philkoh/ClaudeCAD/base_hole_view.png

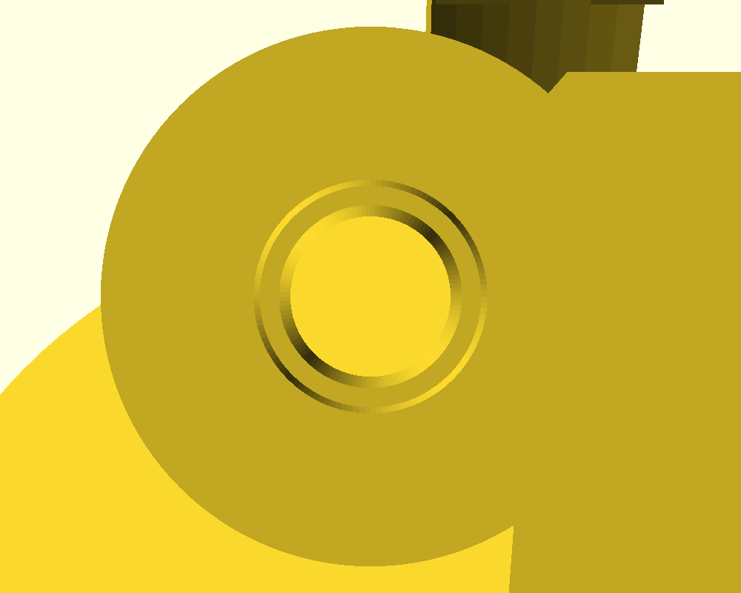
base_hole_view.png
