philkoh/ClaudeCAD/bed_layout.png

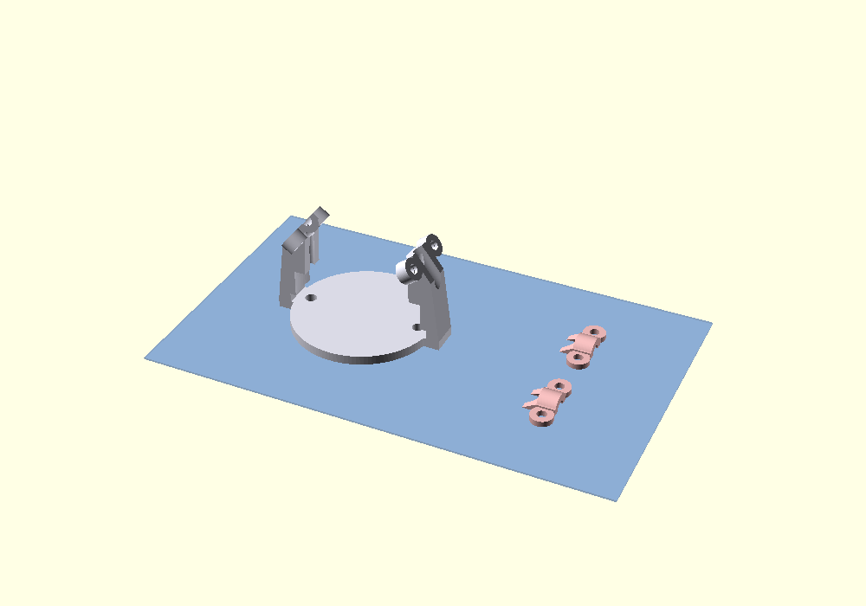
bed_layout.png
