philkoh/ClaudeCAD/bed_preview.png

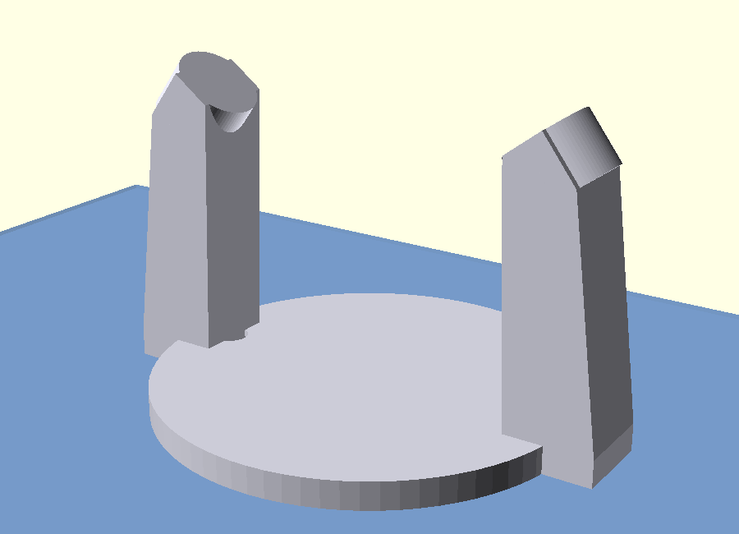
bed_preview.png
