philkoh/ClaudeCAD/hole_detail.png

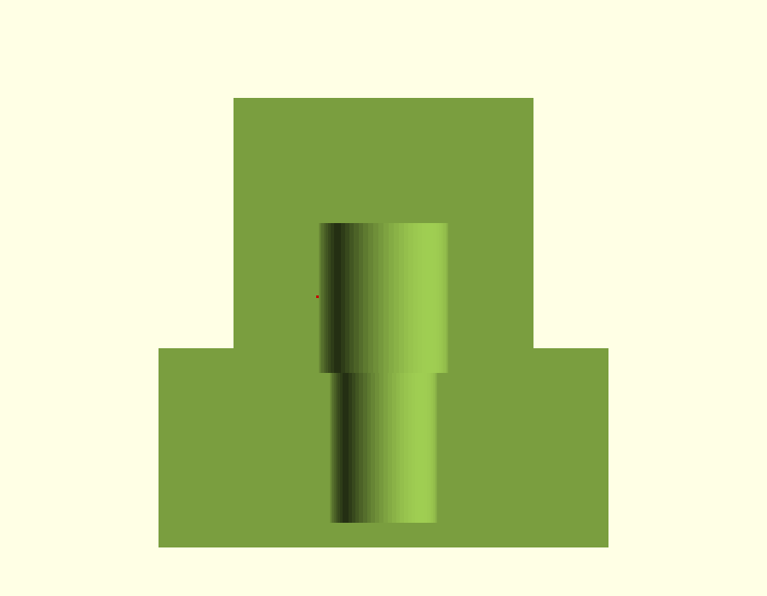
hole_detail.png
