philkoh/ClaudeCAD/mounting_plate_render.png

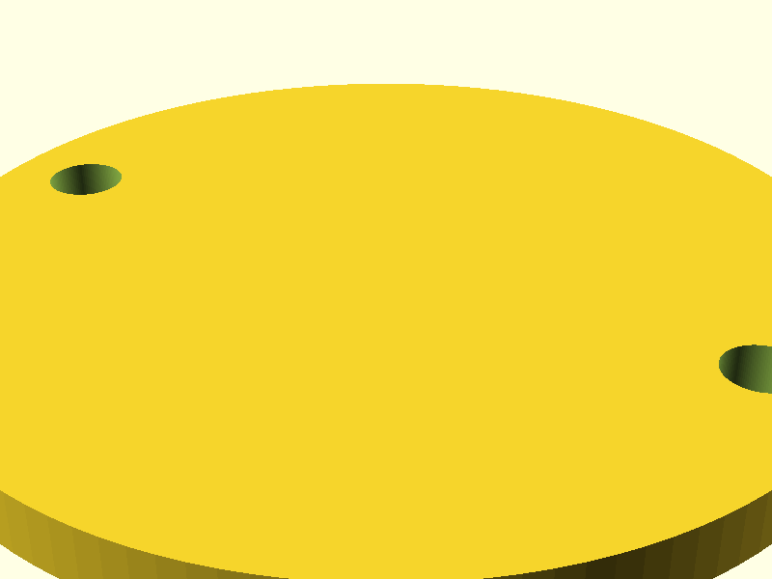
mounting_plate_render.png
