philkoh/ClaudeCAD/base.stl

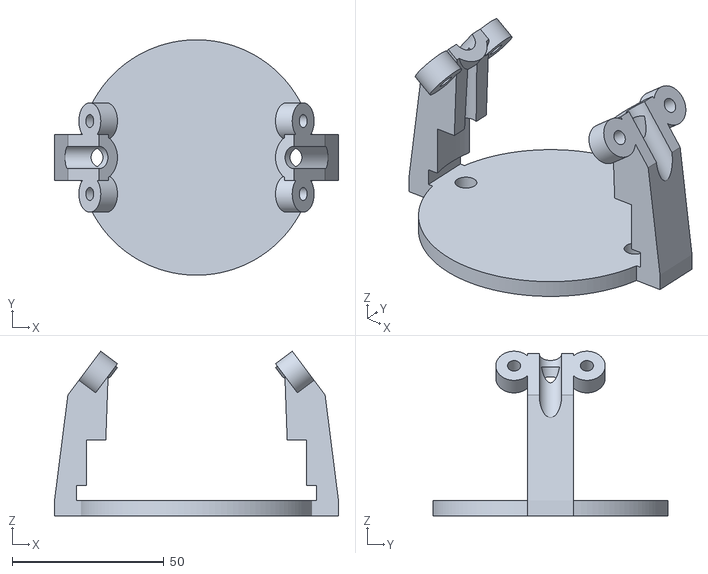
[picture p6: CAD file, 2026-04-12]
base.stl
93.5 x 77.5 x 54.2
