philkoh/ClaudeCAD/clamp_print.stl

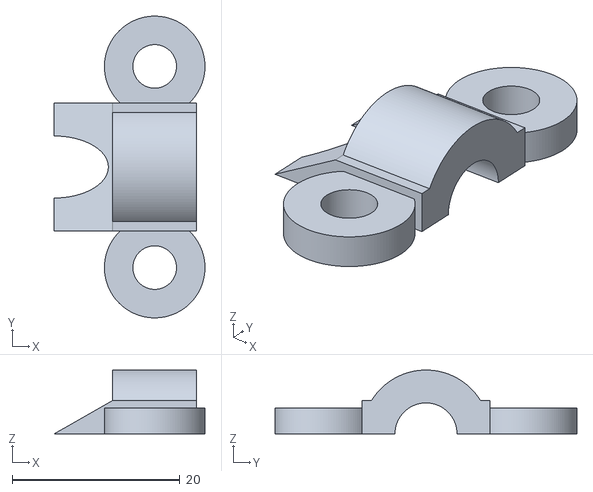
[picture p7: CAD file, 2026-04-12]
clamp_print.stl
18.0 x 36.0 x 7.63
