philkoh/ClaudeCAD/clamp.stl

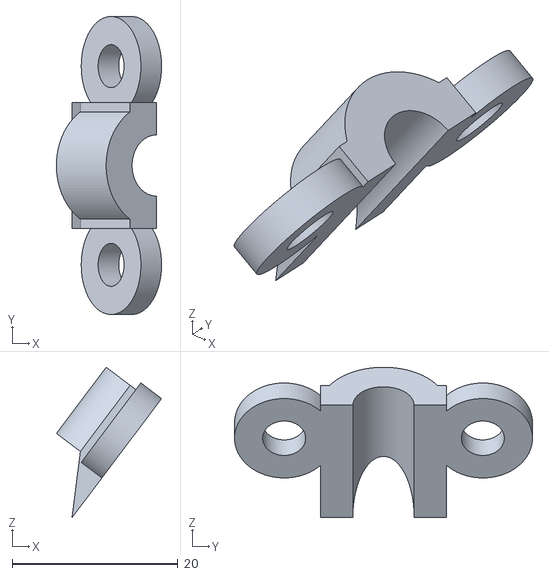
[picture p8: CAD file, 2026-04-12]
clamp.stl
12.7 x 36.0 x 18.2
