philkoh/ClaudeCAD/RevDLowerBracket.STL

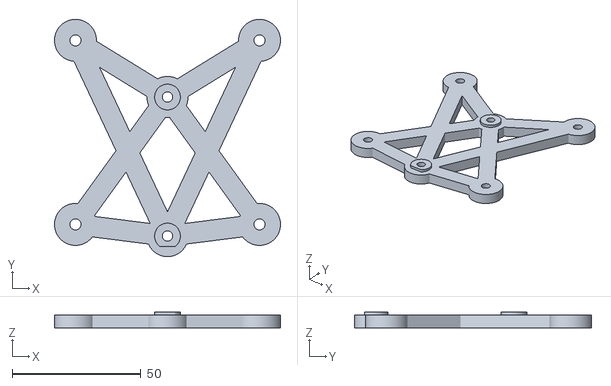
[picture p9: CAD file, 2026-04-03]
RevDLowerBracket.STL
87.8 x 92.1 x 6.20
