philkoh/ClaudeCAD/gripperlite.step

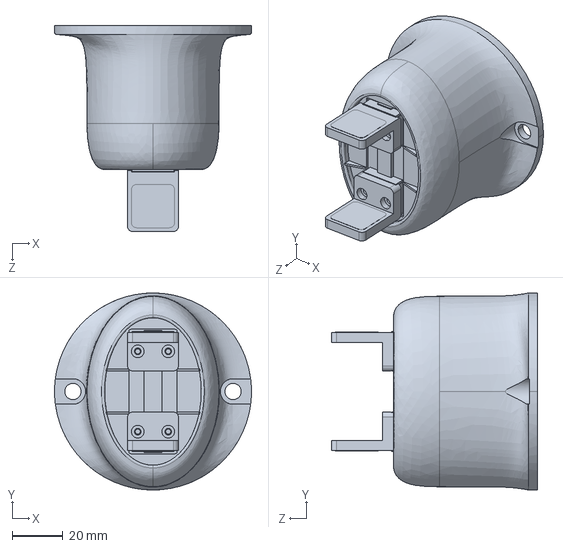
[picture p10: CAD file, 2026-03-31]
gripperlite.step
77.5 x 77.5 x 81.1 mm
