philkoh/ClaudeCAD/assembly_cutplane.scad

// Cross-section view: 1mm slab removed from combined solid along camera axis plane
// Plane contains camera1 axis and is parallel to Y-axis
use <assembly.scad>

$fn = 120;

cam_x = -38.13;
cam_z = 40.39;
tilt_angle = 36.94;

// Combined solid with 1mm slab cut out along camera axis plane
difference() {
    combined_solid();

    // 1mm thick slab centered on the cut plane
    translate([cam_x, 0, cam_z])
        rotate([0, tilt_angle, 0])
            cube([1, 500, 500], center = true);
}

// Gripper and camera unchanged
gripperlite();
camera1();
rim_highlight();
distance_line();
focus_point();
