philkoh/ClaudeCAD/base_hole_view.scad

import("base.stl");
