philkoh/ClaudeCAD/(list of files, cad)

Other CAD files:
clamp_print.scad
export_clamp.scad
export_combined.scad
export_combined_cut.scad
export_combined_v2.scad
gripperlite.stl
