philkoh/ClaudeCAD/assembly_render.png

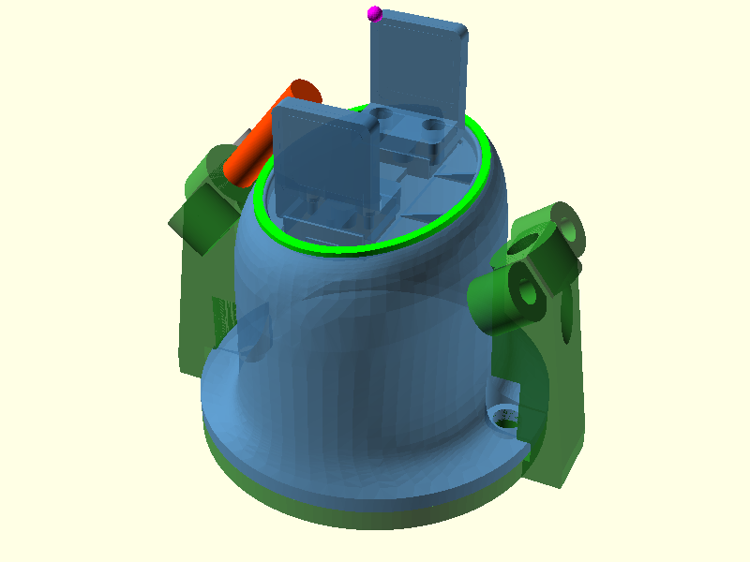
assembly_render.png
