philkoh/ClaudeCAD/assembly_render_cutplane.png

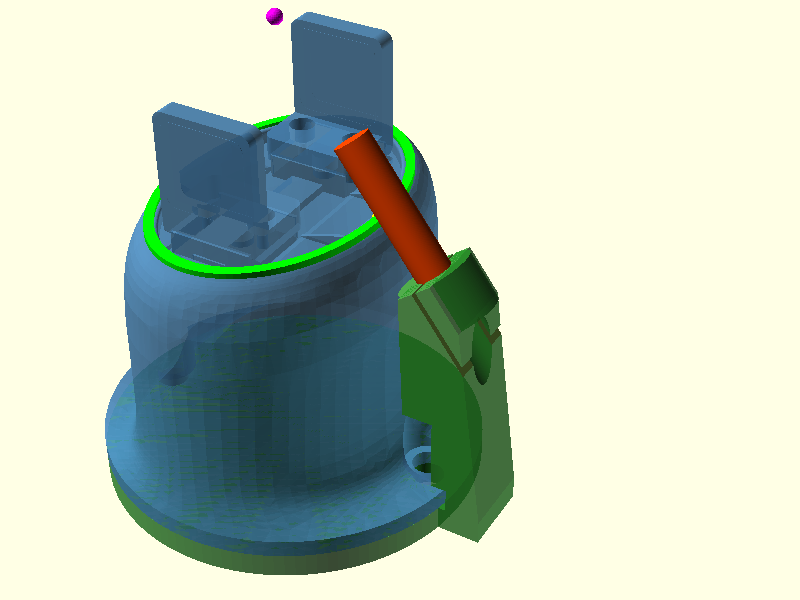
assembly_render_cutplane.png
