philkoh/ClaudeCAD/assembly_render_top.png

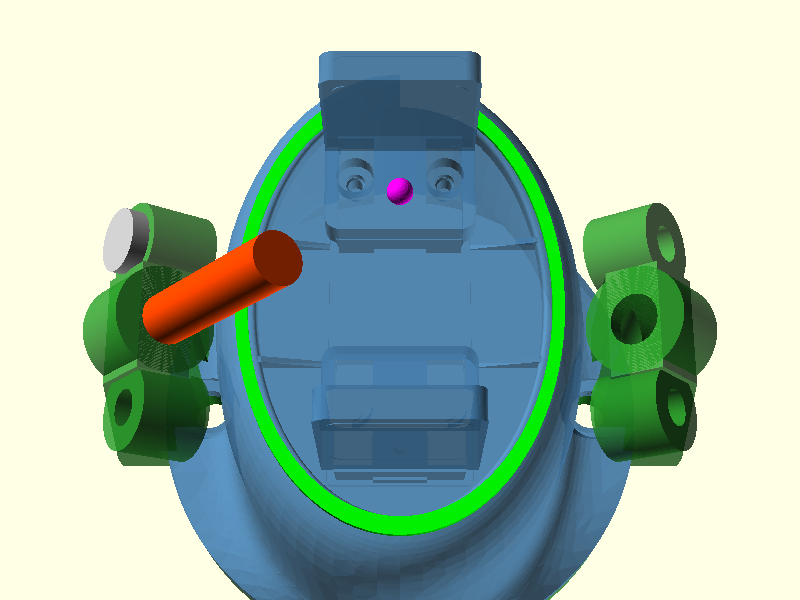
assembly_render_top.png
