philkoh/ClaudeCAD/assembly_render_zoomed.png

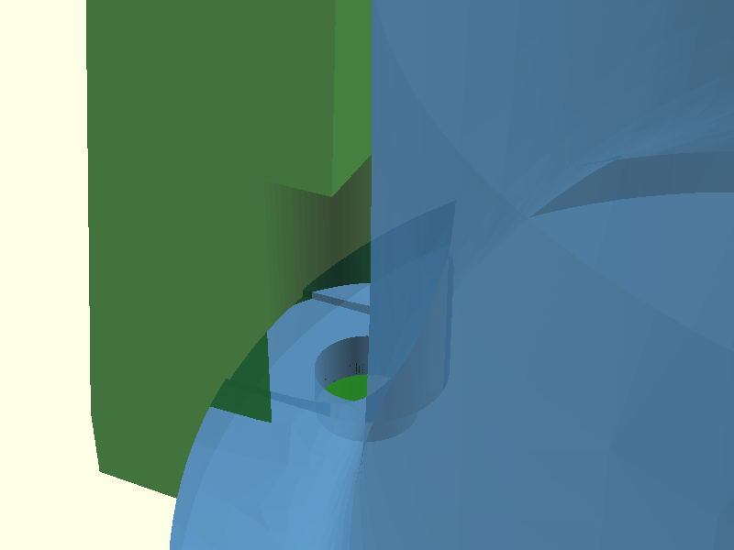
assembly_render_zoomed.png
