philkoh/ClaudeCAD/(commit log)

2026-03-31 Initial commit: gripperlite STEP analysis
    Add reference part (gripperlite.step) and CadQuery analysis script that
    identifies the mounting surface (Z=0, face 152, 4653 mm²) and two
    through-holes at X=±31.5, Y=0, d=6.4mm with d=10mm counterbores.
    [gripperlite.step]
2026-03-31 Add mating plane 2D outline extraction
    Outer perimeter is a circle r=38.75mm at origin with two d=6.4mm
    bolt holes at (±31.5, 0). Area verified to match face 152 exactly.
2026-03-31 Add mounting plate OpenSCAD model and render
    Disc r=38.75mm, 5mm thick, two d=6.4mm bolt holes at X=±31.5mm
    matching the gripperlite mating surface. Includes MCP server config
    for OpenSCAD integration.
    [mounting_plate.scad]
2026-03-31 Add gripper+plate assembly with STL import
    Convert gripperlite.step to STL for OpenSCAD import. Assembly shows
    both parts mated at Z=0 with the plate positioned below the gripper.
    [assembly.scad, gripperlite.stl]
2026-04-01 Add camera1, holder1, arm, and plate as unified solid assembly
    - Camera1: endoscope cylinder (d=7.25, L=38.44) aimed at FocusPoint
    (0,0,91.1), 1mm rim clearance, 25mm focus distance
    - Holder1: cylindrical sleeve (4mm wall) around bottom 10mm of camera
    - Arm: rectangular cross-section beam connecting holder to plate edge,
    with gripper body and screw head clearance cuts
    - Plate + arm + holder1 united into single solid, interference-checked
    - Added rim highlight, distance line, and FocusPoint annotations
    - Export scripts for interference checking via CadQuery
    [assembly.scad, export_combined.scad, export_combined_v2.scad]
2026-04-01 Refine combined solid: camera bore, cutcylinder, and bolt holes
    - Cutcylinder now Z-axis centered, r=37mm (clears gripper interior)
    - Camera bore cut through combined solid for endoscope insertion
    - Bolt holes cut last from combined solid to prevent fill-in
    - Mounting plate simplified to solid disc (holes applied at top level)
    - FreeCAD 1.1.0 installed for assembly visualization
    [assembly.scad, export_combined_v2.scad]
2026-04-03 WristCameraHolder: symmetric part with mirrored arms, holders, and screw bosses
    Complete parametric design of the WristCameraHolder mounting plate:
    - Symmetric about both XZ and YZ planes
    - Two camera holders with bores for endoscope insertion
    - Four screw bosses (d=12mm) with stepped holes (5.2mm clearance / 4.3mm pilot)
    - Arms with gripper body clearance and cutcylinder (r=37mm)
    - Bolt holes (d=6.4mm) at ±31.5mm cut last
    - 1mm slab cuts along camera axis planes for visualization
    - Screw model: M5x10mm PC fan self-tapping (DIN 965 head)
    - Reference part RevDLowerBracket.STL for pilot hole diameter (4.3mm)
    - Full design transcript included for reproducibility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
    [RevDLowerBracket.STL, assembly.scad, assembly_cutplane.scad, export_combined_cut.scad, export_combined_v2.scad]
2026-04-03 Update transcript and add base/clamp export scripts
    - Split combined solid into base + two clamp halves via slab cuts
    - Added export_base.scad and export_clamp.scad for individual STL export
    - Updated design transcript with latest session activity
    [export_base.scad, export_clamp.scad, export_combined_v2.scad]
2026-04-03 Add Dremel 3D45 printer definition, base/clamp export scripts
    - dremel_3d45.def.json: CuraEngine printer definition for Dremel DigiLab 3D45
    - export_base.scad: exports base plate (below slab cuts) as STL
    - export_clamp.scad: exports clamp (above slab cuts) as STL
    - Slab cuts intentionally split combined solid into base + clamp pieces
    - Successfully generated G-code via CuraEngine 5.12.0 (1h18m print)
    - Updated design transcript
2026-04-12 Fix critical printer crash: center-zero coords, unstepped screw holes, Dremel Slicer
    - Set machine_center_is_zero: true in dremel_3d45.def.json (root cause of
    head crash into bed rim — coordinates were offset by half the bed size)
    - Replace Cura template placeholders with literal temp values in start gcode
    - Use metalman3797 reference start/end gcode for Dremel 3D45
    - Change screw holes: base gets Ø4.3mm unstepped (tap), clamp gets Ø5.2mm
    unstepped (clearance) — previously both had identical stepped holes
    - Update endoscope bore from Ø7.25mm to Ø7.4mm across all SCAD files
    - Add Dremel Slicer (OrcaSlicer fork) as recommended slicer with CLI support
    - Add clamp_print.scad for prin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
    [assembly.scad, base.stl, base_hole_view.scad, bed_layout.scad, bed_preview.scad, clamp.stl, clamp_print.scad, clamp_print.stl]
